tomeh2/DC-Electronic-Load/DC Electronic Load.kicad_pcb

## KiCad design DC Electronic Load.kicad_pcb (2024-09-01)

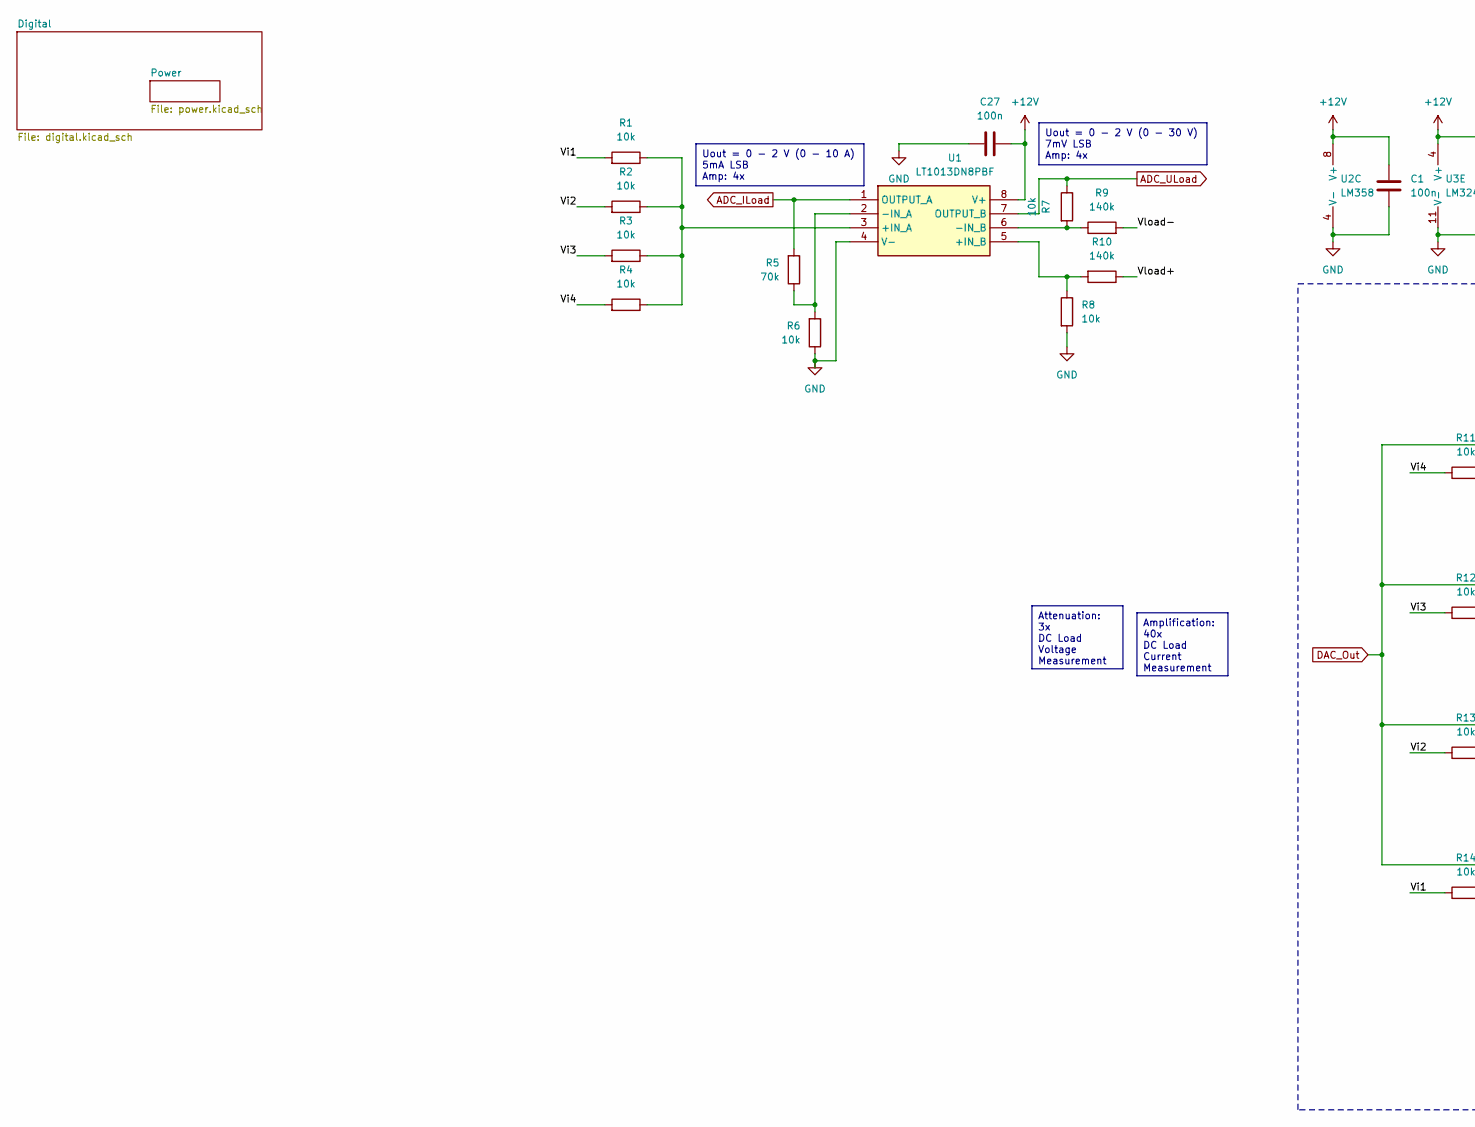
[picture p1: schematic DC Electronic Load.kicad_sch, part in row 1, column 1]

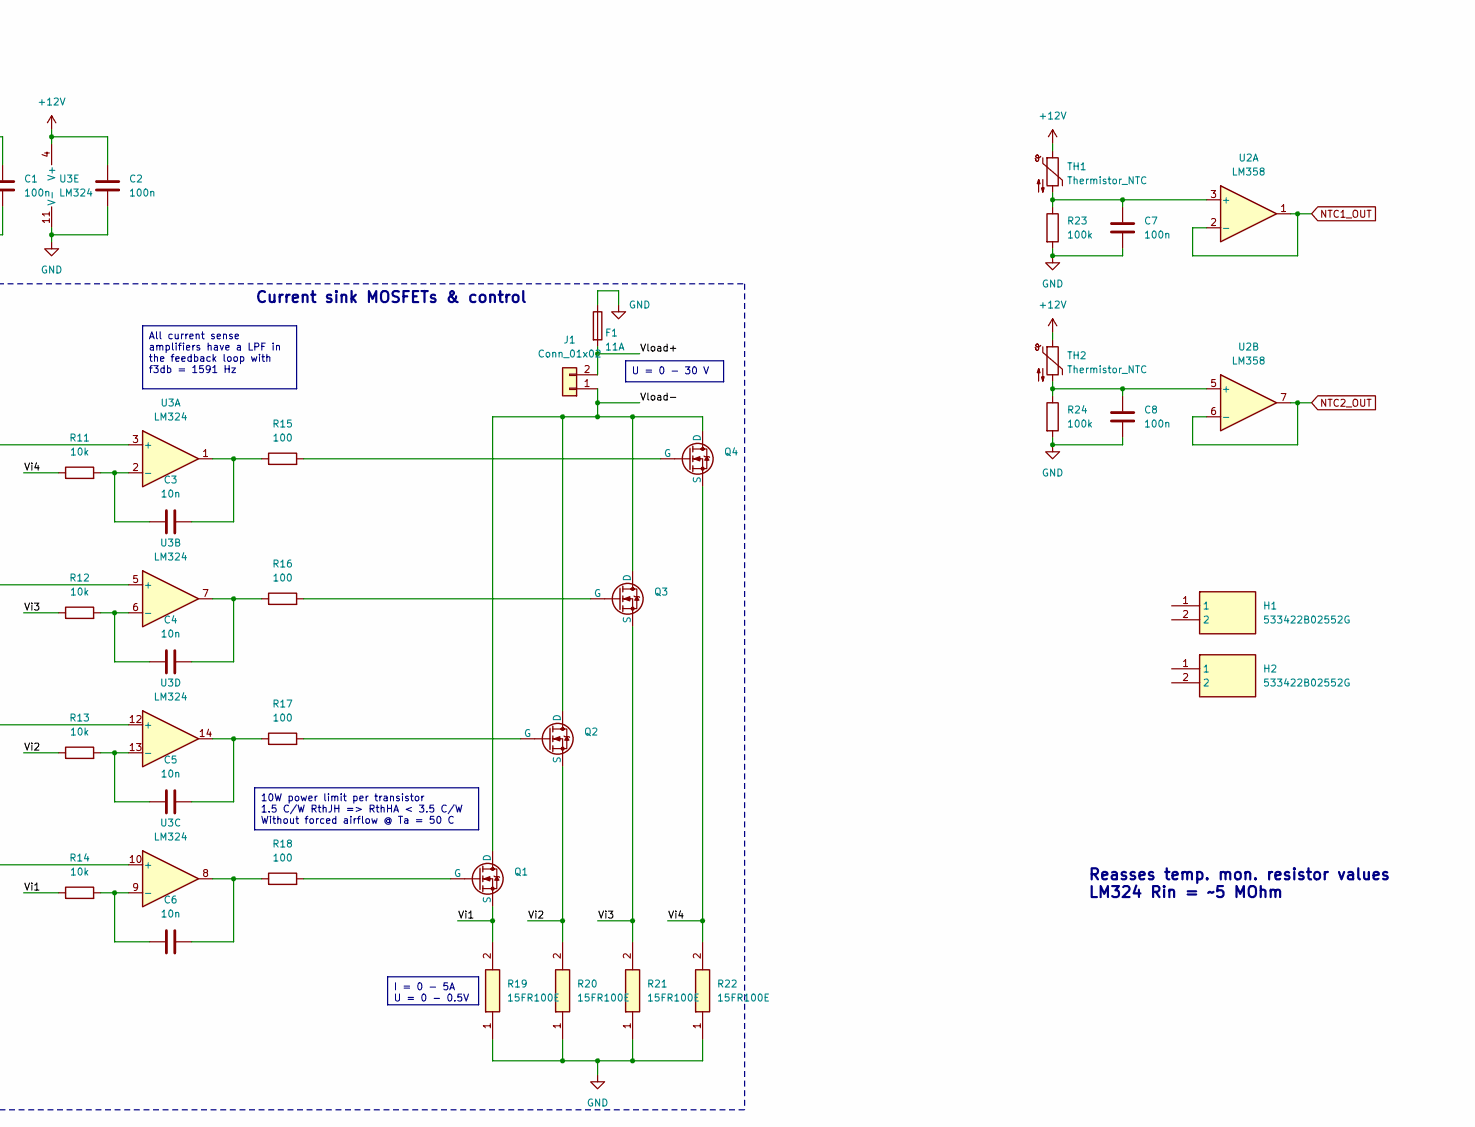
[picture p2: schematic DC Electronic Load.kicad_sch, part in row 1, column 2]

Parts:
C1, C2, C27: 100n; C_Rect_L7.0mm_W2.5mm_P5.00mm; Mouser Part Number 594-K104K15X7RF53H5
C3, C4, C5, C6: 10n; C_Rect_L7.0mm_W2.5mm_P5.00mm; Mouser Part Number 594-K103K10X7RF53H5
C7, C8: 100n; C_Rect_L7.0mm_W2.5mm_P5.00mm
F1: 11A; Fuseholder_Clip-5x20mm_Littelfuse_100_Inline_P20.50x4.60mm_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; Mouser Part Number 576-65600001009
H1, H2: 533422B02552G; Mouser Part Number 532-533422B02552
J1: Conn_01x02; TerminalBlock_Phoenix_MKDS-1,5-2_1x02_P5.00mm_Horizontal; Mouser Part Number 490-TB005-762-02BE
Q1, Q2, Q3, Q4: IXTP100N04T2; TO-220-3_Vertical; Mouser Part Number 747-IXTP100N04T2
R1, R2, R3, R4, R6, R7, R8, R11, R12, R13, R14: 10k; R_Axial_DIN0204_L3.6mm_D1.6mm_P7.62mm_Horizontal; Mouser Part Number 594-5063JD10K1%TR
R5: 70k; R_Axial_DIN0204_L3.6mm_D1.6mm_P7.62mm_Horizontal; Mouser Part Number 603-MFR-25FTE52-30K
R9, R10: 140k; R_Axial_DIN0204_L3.6mm_D1.6mm_P7.62mm_Horizontal; Mouser Part Number 603-MFR-25FTE52-140K
R15, R16, R17, R18: 100; R_Axial_DIN0204_L3.6mm_D1.6mm_P7.62mm_Horizontal; Mouser Part Number 594-SFR2500001000JA5
R19, R20, R21, R22: 15FR100E; RESAD5740W107L2380D840; Mouser Part Number 588-15FR100E
R23, R24: 100k; R_Axial_DIN0204_L3.6mm_D1.6mm_P7.62mm_Horizontal
TH1, TH2: Thermistor_NTC; PinHeader_1x02_P2.54mm_Vertical
U1: LT1013DN8PBF; DIP-8_W7.62mm; Mouser Part Number 595-LT1013DIP
U2: LM358; DIP-8_W7.62mm
U3: LM324; DIP-14_W7.62mm; Mouser Part Number 595-LM324AN

Connections:
+12V: C1.1, C2.1, C27.2, TH1.1, TH2.1, U1.8 (V+), U2.8 (V+), U3.4 (V+); also elsewhere on the board
/Vi1: Q1.3 (S), R1.2, R14.1, R19.2
/Vi2: Q2.3 (S), R2.2, R13.1, R20.2
/Vi3: Q3.3 (S), R3.2, R12.1, R21.2
/Vi4: Q4.3 (S), R4.2, R11.1, R22.2
/Vload+: F1.2, J1.2, R10.1
/Vload-: J1.1, Q1.1 (D), Q2.1 (D), Q3.1 (D), Q4.1 (D), R9.2
ADC_ILoad: R5.2, U1.1 (OUTPUT_A); also elsewhere on the board
ADC_ULoad: R7.1, U1.7 (OUTPUT_B); also elsewhere on the board
DAC_Out: U3.3 (+), U3.5 (+), U3.10 (+), U3.12 (+); also elsewhere on the board
GND: C1.2, C2.2, C7.2, C8.2, C27.1, F1.1, R6.1, R8.2, R19.1, R20.1, R21.1, R22.1, R23.2, R24.2, U1.4 (V-), U2.4 (V-), U3.11 (V-); also elsewhere on the board
NTC1_OUT: U2.1, U2.2 (-); also elsewhere on the board
NTC2_OUT: U2.6 (-), U2.7; also elsewhere on the board
unnamed: C3.2, R15.1, U3.1
unnamed: C4.2, R16.1, U3.7
unnamed: C5.2, R17.1, U3.14
unnamed: C6.2, R18.1, U3.8
unnamed: Q1.2 (G), R18.2
unnamed: Q2.2 (G), R17.2
unnamed: Q3.2 (G), R16.2
unnamed: Q4.2 (G), R15.2
unnamed: R1.1, R2.1, R3.1, R4.1, U1.3 (+IN_A)
unnamed: R8.1, R10.2, U1.5 (+IN_B)
unnamed: R5.1, R6.2, U1.2 (-IN_A)
unnamed: R7.2, R9.1, U1.6 (-IN_B)
unnamed: C7.1, R23.1, TH1.2, U2.3 (+)
unnamed: C8.1, R24.1, TH2.2, U2.5 (+)
unnamed: C3.1, R11.2, U3.2 (-)
unnamed: C4.1, R12.2, U3.6 (-)
unnamed: C6.1, R14.2, U3.9 (-)
unnamed: C5.1, R13.2, U3.13 (-)

Notes on the sheet:
All current sense amplifiers have a LPF in the feedback loop with f3db = 1591 Hz
Uout = 0 - 2 V (0 - 10 A) 5mA LSB Amp: 4x
U = 0 - 30 V
10W power limit per transistor 1.5 C/W RthJH => RthHA < 3.5 C/W Without forced airflow @ Ta = 50 C
Amplification: 40x DC Load Current Measurement
Uout = 0 - 2 V (0 - 30 V) 7mV LSB Amp: 4x
I = 0 - 5A U = 0 - 0.5V
Attenuation: 3x DC Load Voltage Measurement
Current sink MOSFETs & control
Reasses temp. mon. resistor values LM324 Rin = ~5 MOhm

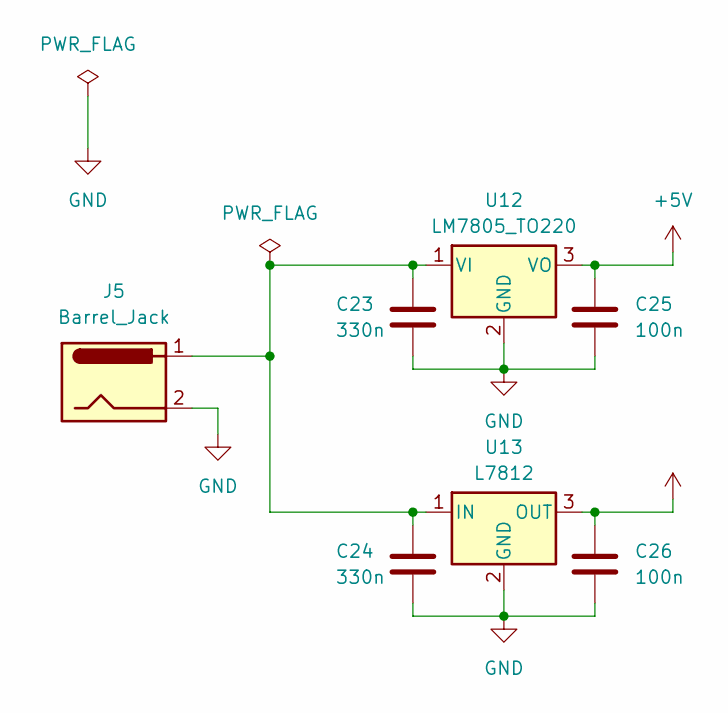
[picture p3: schematic power.kicad_sch]

Parts:
C23, C24: 330n; C_Rect_L7.0mm_W2.5mm_P5.00mm
C25, C26: 100n; C_Rect_L7.0mm_W2.5mm_P5.00mm
J5: Barrel_Jack; TerminalBlock_Phoenix_MKDS-1,5-2_1x02_P5.00mm_Horizontal
U12: LM7805_TO220; TO-220-3_Vertical
U13: L7812; TO-220-3_Vertical

Connections:
+5V: C25.1, U12.3 (VO); also elsewhere on the board
+12V: C26.1, U13.3 (OUT); also elsewhere on the board
GND: C23.2, C24.2, C25.2, C26.2, J5.2, U12.2 (GND), U13.2 (GND); also elsewhere on the board
unnamed: C23.1, C24.1, J5.1, U12.1 (VI), U13.1 (IN)

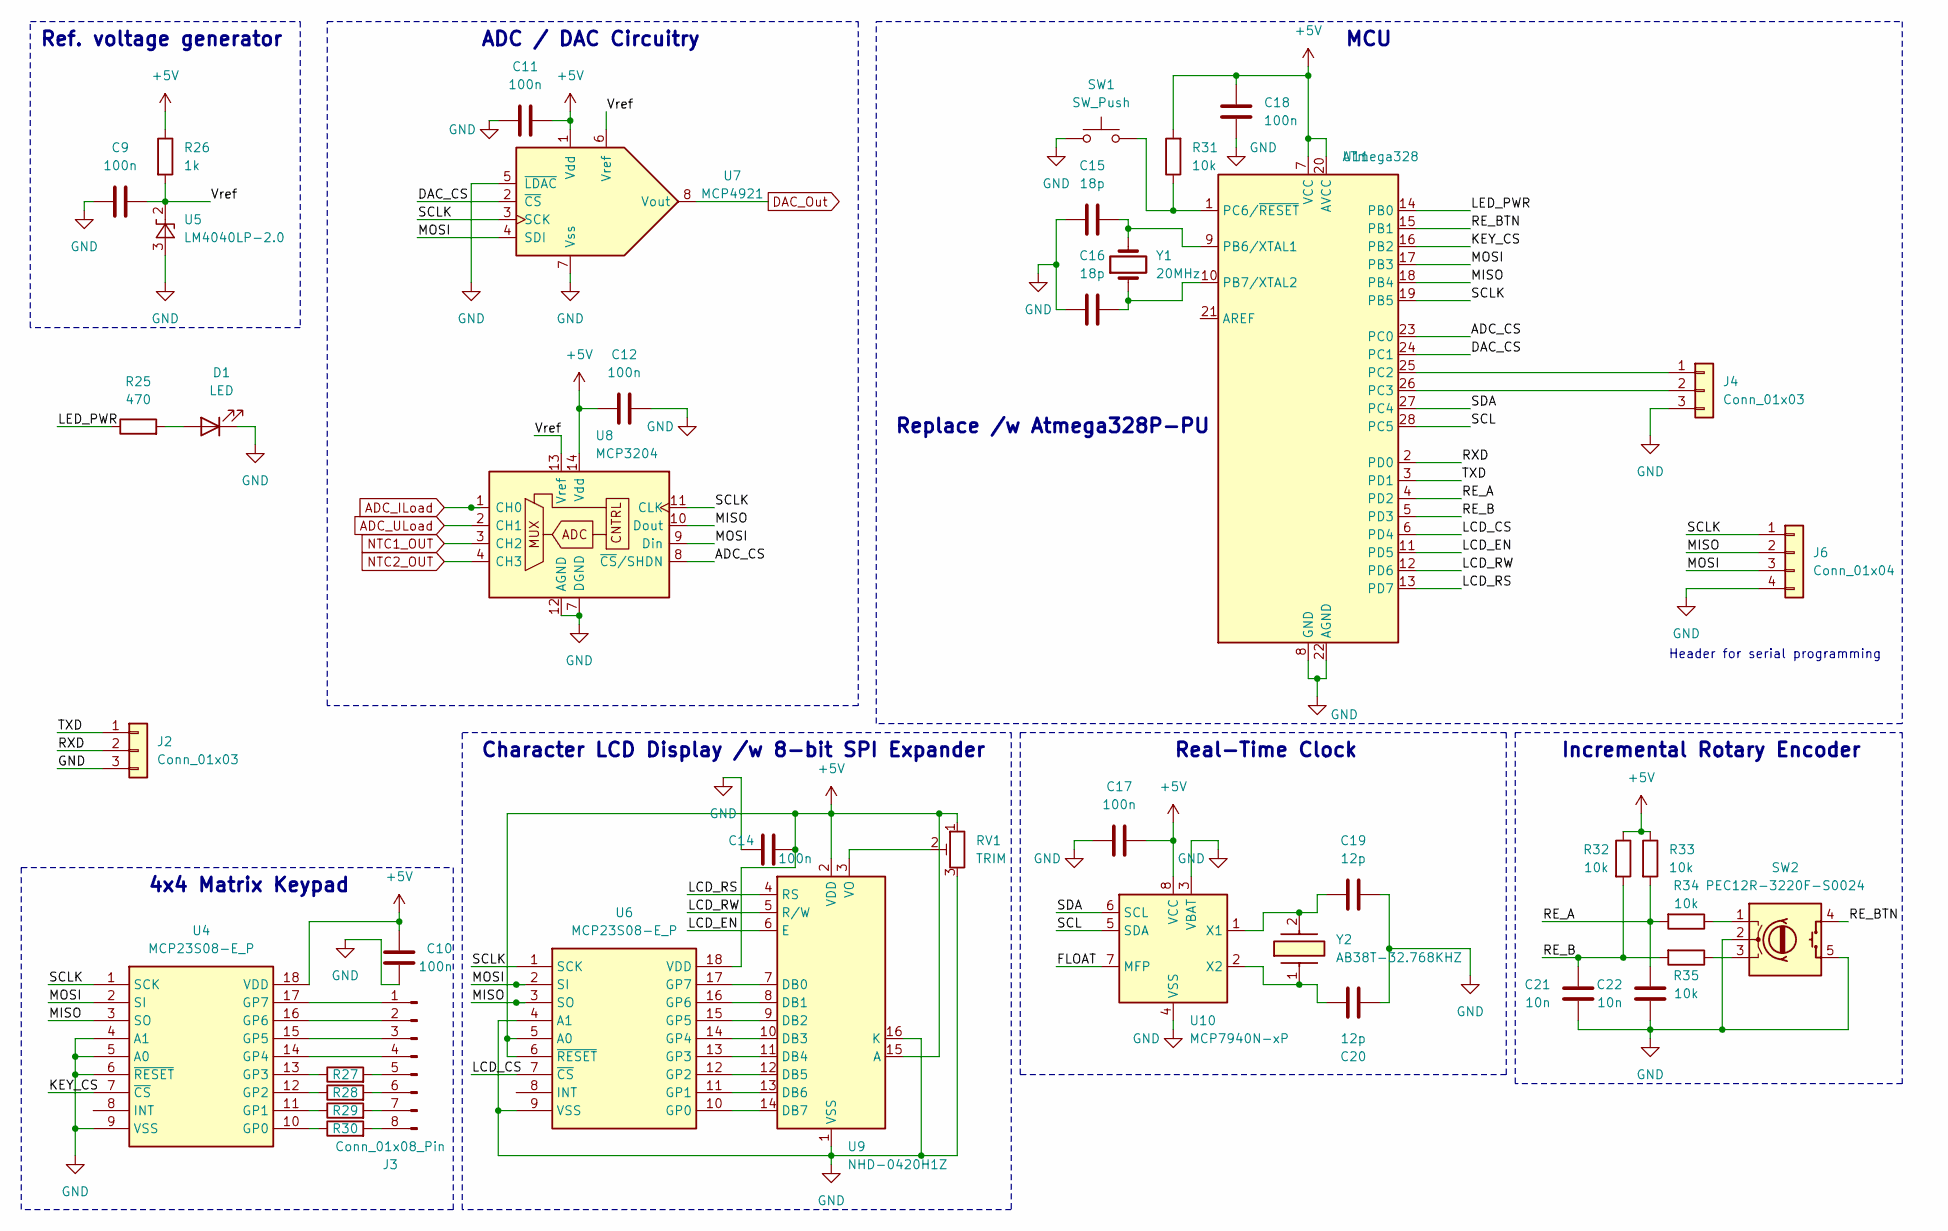
[picture p4: schematic digital.kicad_sch]

Parts:
C9, C10, C11, C12, C14, C17, C18: 100n; C_Rect_L7.0mm_W2.5mm_P5.00mm; Mouser Part Number 594-K104K15X7RF53H5
C15, C16: 18p; C_Disc_D5.0mm_W2.5mm_P5.00mm; Mouser Part Number 80-C317C180J2G
C19, C20: 12p; C_Disc_D5.0mm_W2.5mm_P5.00mm; Mouser Part Number 80-C317C120J5G
C21, C22: 10n; C_Rect_L7.0mm_W2.5mm_P5.00mm; Mouser Part Number 594-K104K15X7RF53H5
D1: LED; LED_D3.0mm; Mouser Part Number 696-SSL-LX30FT4GD
J2, J4: Conn_01x03; PinHeader_1x03_P2.54mm_Vertical; Mouser Part Number 649-78511-403HLF
J3: Conn_01x08_Pin; PinHeader_1x08_P2.54mm_Vertical
J6: Conn_01x04; PinHeader_1x04_P2.54mm_Vertical
R25: 470; R_Axial_DIN0204_L3.6mm_D1.6mm_P7.62mm_Horizontal; Mouser Part Number 603-MFR-25FTE52-470R
R26, R27, R28, R29, R30: 1k; R_Axial_DIN0204_L3.6mm_D1.6mm_P7.62mm_Horizontal; Mouser Part Number 603-MFR-25FTE52-1K
R31, R32, R33, R34, R35: 10k; R_Axial_DIN0204_L3.6mm_D1.6mm_P7.62mm_Horizontal; Mouser Part Number 594-5063JD10K1%TR
RV1: TRIM; Potentiometer_ACP_CA9-H2,5_Horizontal; Mouser Part Number 531-PT10V-20K
SW1: SW_Push; SW_PUSH_6mm; Mouser Part Number 179-TS026650BK160LCR
SW2: PEC12R-3220F-S0024; PinHeader_1x05_P2.54mm_Vertical; Mouser Part Number 652-PEC12R3220FS0024
U4, U6: MCP23S08-E_P; DIP-18_W7.62mm; Mouser Part Number 579-MCP23S08-E/P
U5: LM4040LP-2.0; TO-92_Inline; Mouser Part Number 595-LM4040C20ILPR
U7: MCP4921; DIP-8_W7.62mm; Mouser Part Number 579-MCP4921-E/P
U8: MCP3204; DIP-14_W7.62mm
U9: NHD-0420H1Z; PinHeader_1x16_P2.54mm_Vertical; Mouser Part Number 763-NHD0420H1ZFSWGBW
U10: MCP7940N-xP; DIP-8_W7.62mm; Mouser Part Number 579-MCP7940N-I/P
U11: ATmega328; DIP-28_W7.62mm; Mouser Part Number 556-ATMEGA8A-PU
Y1: 20MHz; Crystal_HC49-U_Vertical; Mouser Part Number 815-ABL16000MHZB4YT
Y2: AB38T-32.768KHZ; AB38T32768KHZ; Mouser Part Number 815-AB38T-32.768KHZ

Connections:
+5V: C10.2, C11.1, C12.2, C14.1, C17.1, C18.2, R26.1, R31.2, R32.1, R33.1, RV1.1, U4.18 (VDD), U6.5 (A0), U6.6 (~RESET), U6.18 (VDD), U7.1 (Vdd), U8.14 (Vdd), U9.2 (VDD), U9.15 (A), U10.8 (VCC), U11.7 (VCC), U11.20 (AVCC); also elsewhere on the board
/Digital/ADC_CS: U8.8 (~CS/SHDN), U11.23 (PC0)
/Digital/DAC_CS: U7.2 (~CS), U11.24 (PC1)
/Digital/FLOAT: U10.7 (MFP)
/Digital/KEY_CS: U4.7 (~CS), U11.16 (PB2)
/Digital/LCD_CS: U6.7 (~CS), U11.6 (PD4)
/Digital/LCD_EN: U9.6 (E), U11.11 (PD5)
/Digital/LCD_RS: U9.4 (RS), U11.13 (PD7)
/Digital/LCD_RW: U9.5 (R/W), U11.12 (PD6)
/Digital/LED_PWR: R25.1, U11.14 (PB0)
/Digital/MISO: J6.2, U4.3 (SO), U6.3 (SO), U8.10 (Dout), U11.18 (PB4)
/Digital/MOSI: J6.3, U4.2 (SI), U6.2 (SI), U7.4 (SDI), U8.9 (Din), U11.17 (PB3)
/Digital/RE_A: C22.2, R33.2, R34.2, U11.4 (PD2)
/Digital/RE_B: C21.2, R32.2, R35.2, U11.5 (PD3)
/Digital/RE_BTN: SW2.4 (S1), U11.15 (PB1)
/Digital/RXD: J2.2, U11.2 (PD0)
/Digital/SCL: U10.5 (SDA), U11.28 (PC5)
/Digital/SCLK: J6.1, U4.1 (SCK), U6.1 (SCK), U7.3 (SCK), U8.11 (CLK), U11.19 (PB5)
/Digital/SDA: U10.6 (SCL), U11.27 (PC4)
/Digital/TXD: J2.1, U11.3 (PD1)
/Digital/Vref: C9.2, R26.2, U5.2 (K), U7.6 (Vref), U8.13 (Vref)
ADC_ILoad: U8.1 (CH0); also elsewhere on the board
ADC_ULoad: U8.2 (CH1); also elsewhere on the board
DAC_Out: U7.8 (Vout); also elsewhere on the board
GND: C9.1, C10.1, C11.2, C12.1, C14.2, C15.1, C16.1, C17.2, C18.1, C19.2, C20.2, C21.1, C22.1, D1.1 (K), J2.3, J4.3, J6.4, RV1.3, SW1.1, SW2.2 (C), SW2.5 (S2), U4.4 (A1), U4.5 (A0), U4.6 (~RESET), U4.9 (VSS), U5.3 (A), U6.4 (A1), U6.9 (VSS), U7.5 (~LDAC), U7.7 (Vss), U8.7 (DGND), U8.12 (AGND), U9.1 (VSS), U9.16 (K), U10.3 (VBAT), U10.4 (VSS), U11.8 (GND), U11.22 (AGND); also elsewhere on the board
NTC1_OUT: U8.3 (CH2); also elsewhere on the board
NTC2_OUT: U8.4 (CH3); also elsewhere on the board
unnamed: D1.2 (A), R25.2
unnamed: J3.1, U4.17 (GP7)
unnamed: J3.2, U4.16 (GP6)
unnamed: J3.3, U4.15 (GP5)
unnamed: J3.4, U4.14 (GP4)
unnamed: J3.5, R27.2
unnamed: J3.6, R28.2
unnamed: J3.7, R29.2
unnamed: J3.8, R30.2
unnamed: J4.1, U11.25 (PC2)
unnamed: J4.2, U11.26 (PC3)
unnamed: R34.1, SW2.1 (A)
unnamed: R35.1, SW2.3 (B)
unnamed: R30.1, U4.10 (GP0)
unnamed: R29.1, U4.11 (GP1)
unnamed: R28.1, U4.12 (GP2)
unnamed: R27.1, U4.13 (GP3)
unnamed: U6.10 (GP0), U9.14 (DB7)
unnamed: U6.11 (GP1), U9.13 (DB6)
unnamed: U6.12 (GP2), U9.12 (DB5)
unnamed: U6.13 (GP3), U9.11 (DB4)
unnamed: U6.14 (GP4), U9.10 (DB3)
unnamed: U6.15 (GP5), U9.9 (DB2)
unnamed: U6.16 (GP6), U9.8 (DB1)
unnamed: U6.17 (GP7), U9.7 (DB0)
unnamed: RV1.2, U9.3 (VO)
unnamed: C19.1, U10.1 (X1), Y2.2
unnamed: C20.1, U10.2 (X2), Y2.1
unnamed: C15.2, U11.9 (PB6/XTAL1), Y1.2
unnamed: C16.2, U11.10 (PB7/XTAL2), Y1.1
unnamed: R31.1, SW1.2, U11.1 (PC6/~RESET)

Notes on the sheet:
Incremental Rotary Encoder
MCU
ADC / DAC Circuitry
Character LCD Display /w 8-bit SPI Expander
Replace /w Atmega328P-PU
Real-Time Clock
Header for serial programming
Ref. voltage generator
4x4 Matrix Keypad

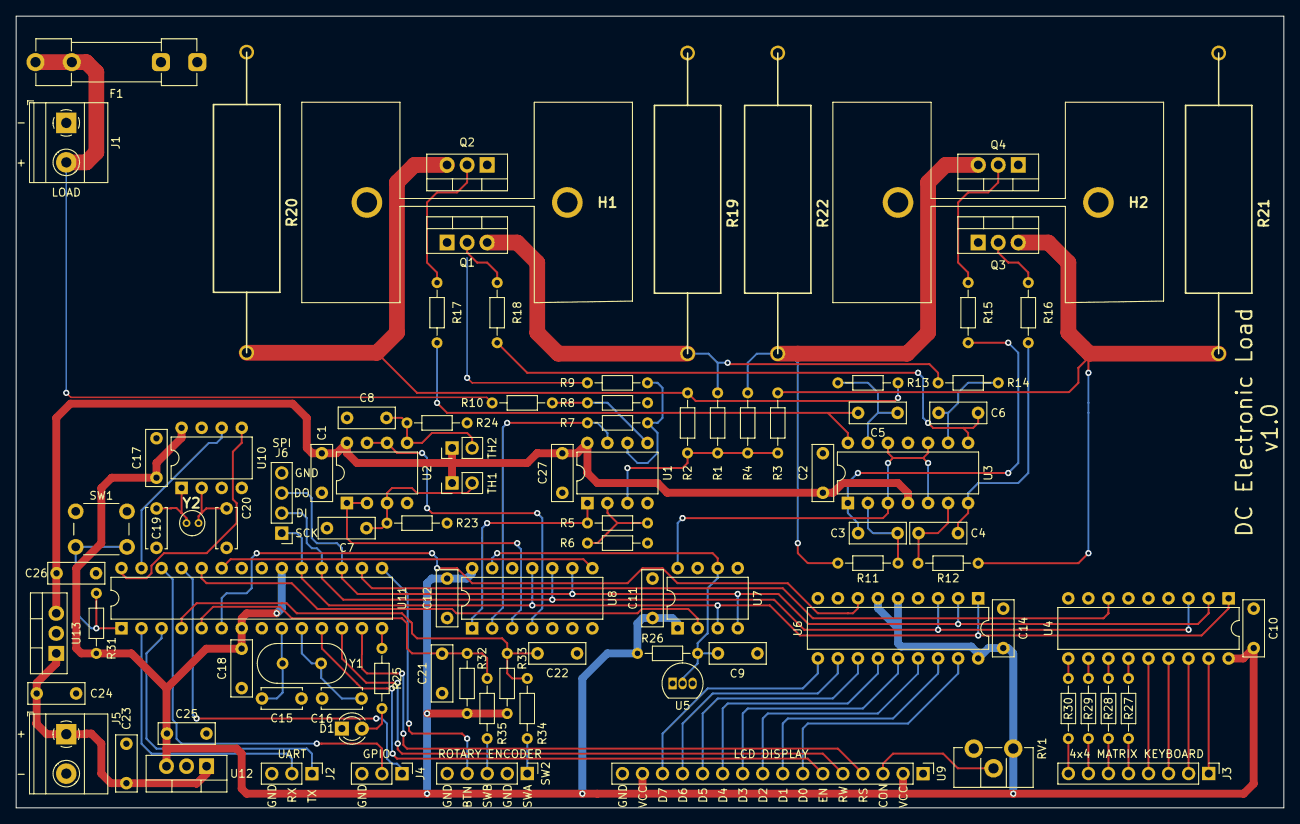
[picture p5: board DC Electronic Load.kicad_pcb from above]

Board: 2 copper layers, 160.7 x 100.3 mm, 95 parts (0 on the bottom side), 83 nets.
